crparaizo/tcc_ifsp_2023/README.md

<h2 align="center"> TCC - IFSP - 2023 </h2>

<h1 align="center"> Sistema de Aquisição de Sinais com ESP32 </h1>

<p text-align="justify" text-justify="inter-word">Desenvolvimento de um sistema de aquisição de sinais com algumas funcionalidades similares a de um osciloscópio digital, com base no microcontrolador ESP32, para que o custo e a portabilidade não seja um empecilho para estudantes e professores que desejam aprimorar seus conhecimentos.
</p>

<p text-align="justify" text-justify="inter-word">Versão final do projeto está na pasta 'ESP32_Aquisicao_Sinais', as demais pastas são testes desenvolvidos e utilizados durante o TCC.</p>

<p text-align="justify" text-justify="inter-word">A documentação tanto do software desenvolvido, como do hardware criado, está descrita no PDF "MONOGRAFIA_AQUISICAO_SINAIS_ESP32", assim com as intruções de como utilizá-los</p>
