crparaizo/tcc_ifsp_2023/(commit log)

2023-05-02 acrescentando pasta com arquivos de frontend estruturados e responsivos e teste com grafico dinamico
2023-05-15 adicionando código de webserver com inclusao de sinal DAC para segrar onda triangular
